SerhiiLe/Attiny13_Torch/(list of files, drawings)

Other design files:
attiny13_torch_n-ch.sim1
attiny13_torch_p-ch.sim1
